prusa3d/SL-CONTROLLER-PCB/rev.06c/SL-controller-06c.pdf

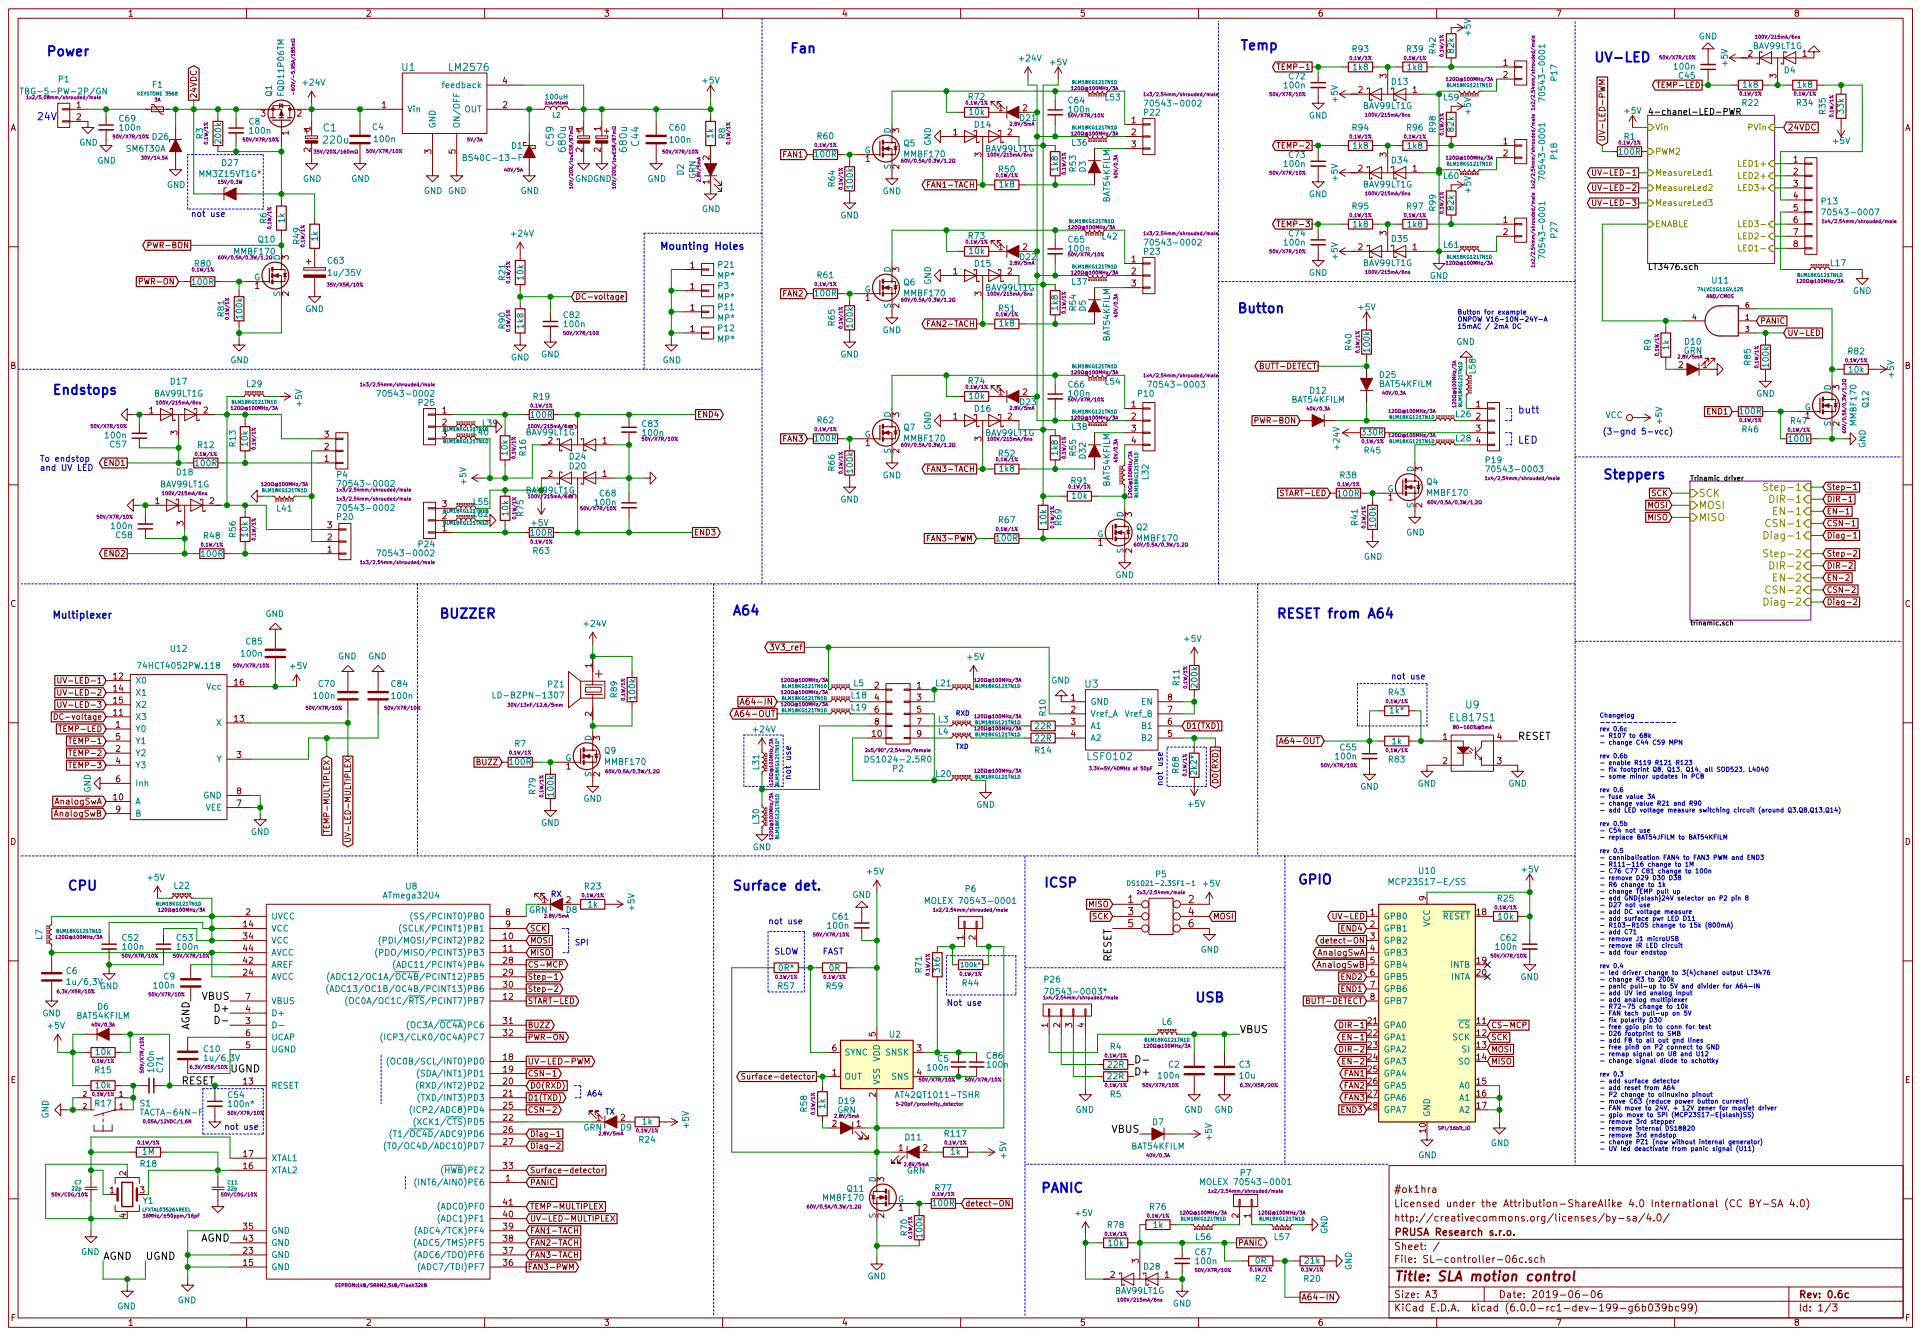
[picture p2: page 1]

TEMP-1 TEMP-2 TEMP-3 GND

Button for example ONPOW V16-10N-24Y-A

Step-1 DIR-1 EN-1 CSN-1 Step-2 DIR-2 EN-2 CSN-2 Diag-2 Diag-1 SCK MOSI MISO

Diag-1
Step-2 DIR-2 EN-2 CSN-2

+5V GND
UV-LED-2 UV-LED-3

Changelog
rev 0.6c
- change C44 C59 MPN
rev 0.6b
- enable R119 R121 R123
- fix footprint Q8, Q13, Q14, all SOD523, L4040
- some minor updates in PCB
rev 0.6
- fuse value 3A
- change value R21 and R90
- add LED voltage measure switching circuit (around Q3,Q8,Q13,Q14)
rev 0.5b
- C54 not use
- replace BAT54JFILM to BAT54KFILM
rev 0.5
- cannibalisation FAN4 to FAN3 PWM and END3
- R111-116 change to 1M
- C76 C77 C81 change to 100n
- remove D29 D30 D38

- R6 change to 1k
- change TEMP pull up
- add GND{slash}24V selector on P2 pin 8
- D27 not use
- add DC voltage measure
- add surface pwr LED D11
- R103-R105 change to 15k (800mA)
- add C71
- remove J1 microUSB
- remove IR LED circuit - add four endstop

rev 0.4
- led driver change to 3(4)chanel output LT3476
- change R3 to 200k
- panic pull-up to 5V and divider for A64-IN
- add UV led analog input - add analog multiplexer
- R72-75 change to 10k
- FAN tach pull-up on 5V
- fix polarity D30
- free gpio pin to conn for test - D26 footprint to SMB
- add FB to all out gnd lines
- free pin8 on P2 connect to GND
- remap signal on U8 and U12

- change signal diode to schottky
rev 0.3
- add surface detector
- add reset from A64
- P2 change to olinuxino pinout - move C63 (reduce power button current)
- FAN move to 24V, + 12V zener for mosfet driver
- gpio move to SPI (MCP23S17-E{slash}SS)
- remove 3rd stepper
- remove internal DS18B20
- remove 3rd endstop
- change PZ1 (now without internal generator)
- UV led deactivate from panic signal (U11)

Licensed under the Attribution-ShareAlike 4.0 International (CC BY-SA 4.0) #ok1hra

Id: 1/3 Title: SLA motion control File: SL-controller-06c.sch Sheet: / PRUSA Research s.r.o. http://creativecommons.org/licenses/by-sa/4.0/

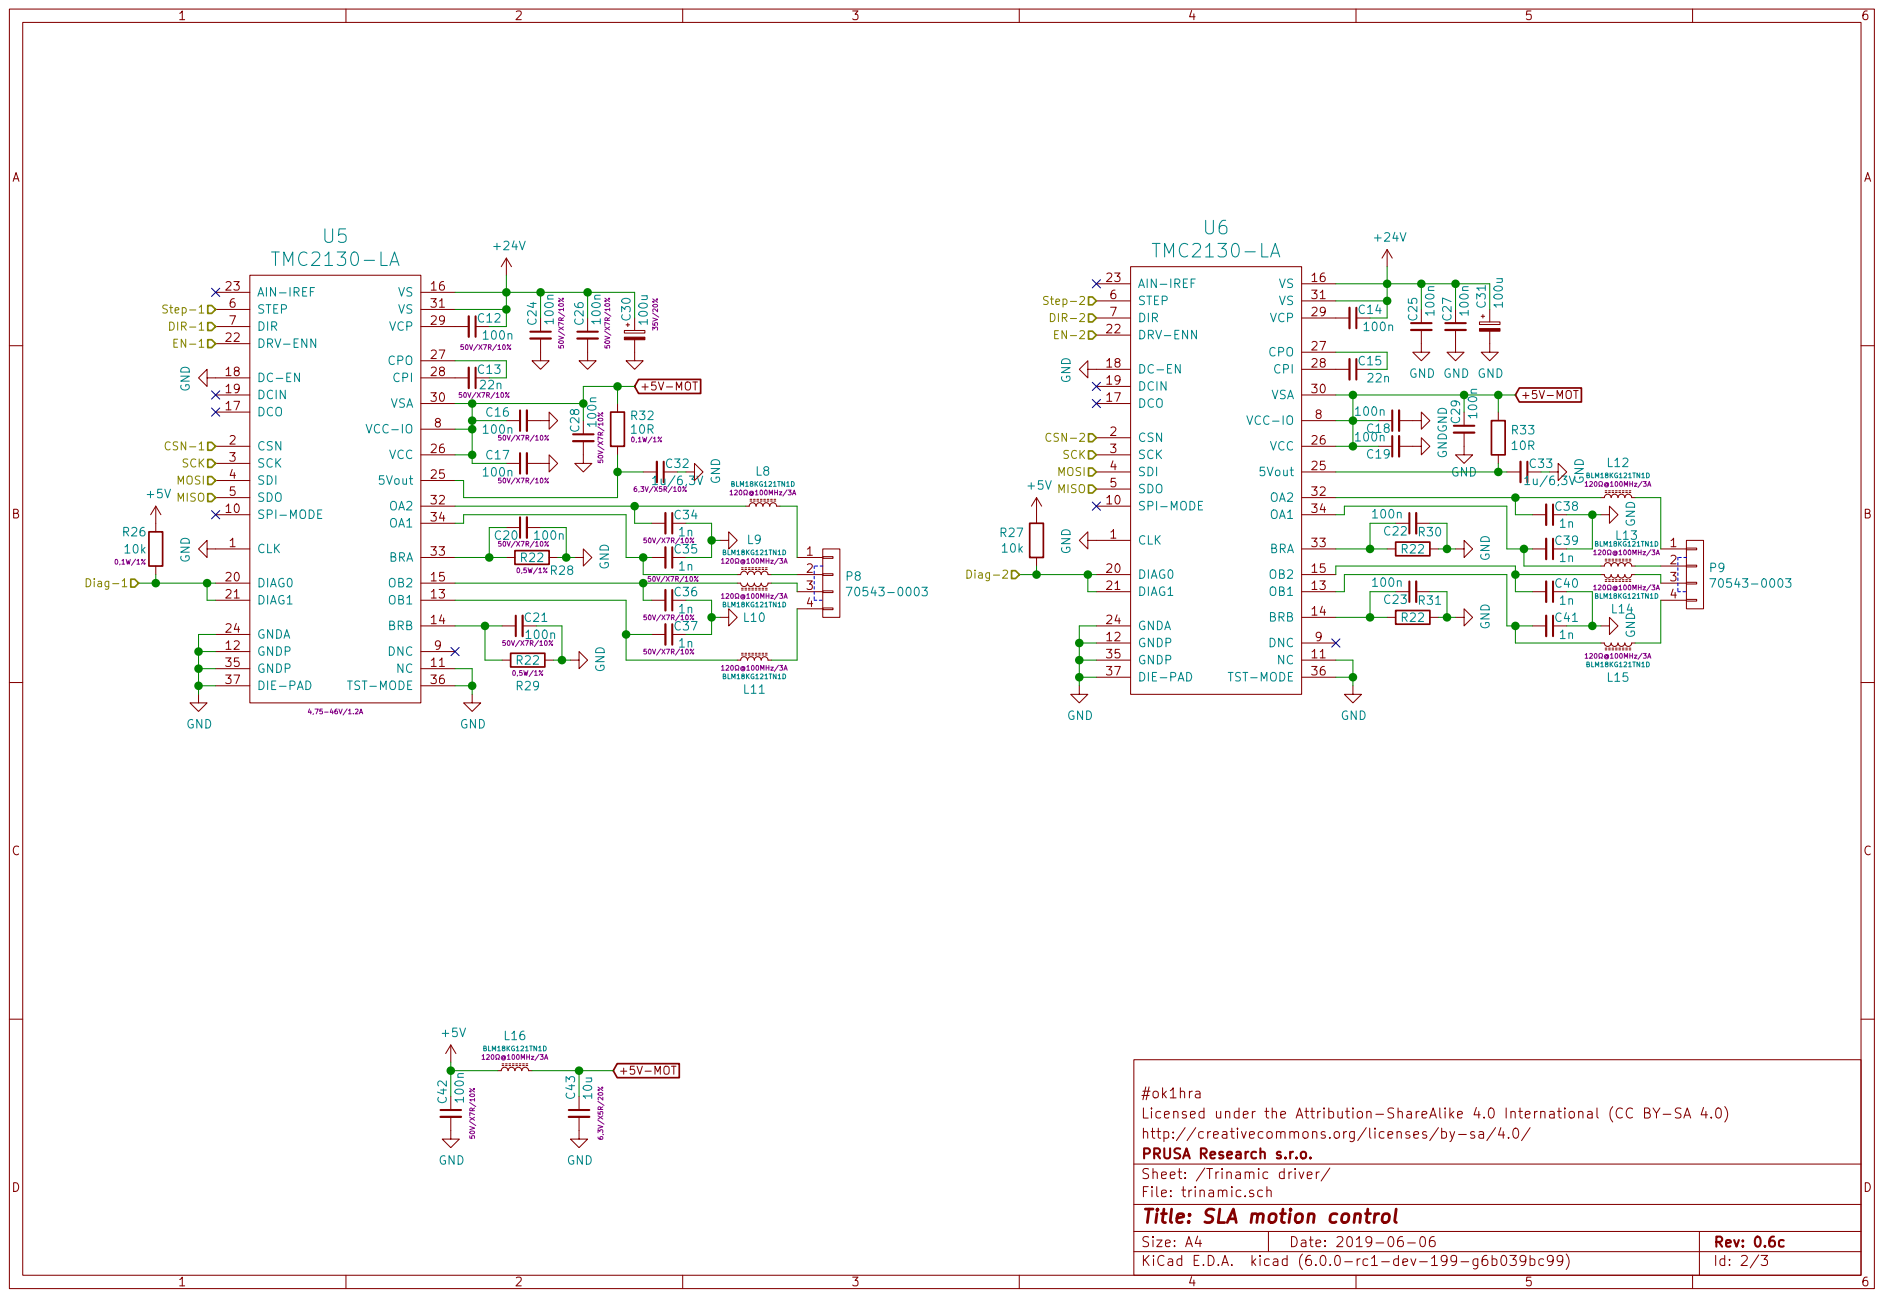
[picture p3: page 2]

TMC2130-LA GND GND
Step-2 DIR-2 EN-2 CSN-2 SCK MOSI MISO

Step-1 DIR-1 EN-1 CSN-1 SCK MOSI MISO

Id: 2/3 Title: SLA motion control File: trinamic.sch Sheet: /Trinamic driver/ PRUSA Research s.r.o. http://creativecommons.org/licenses/by-sa/4.0/

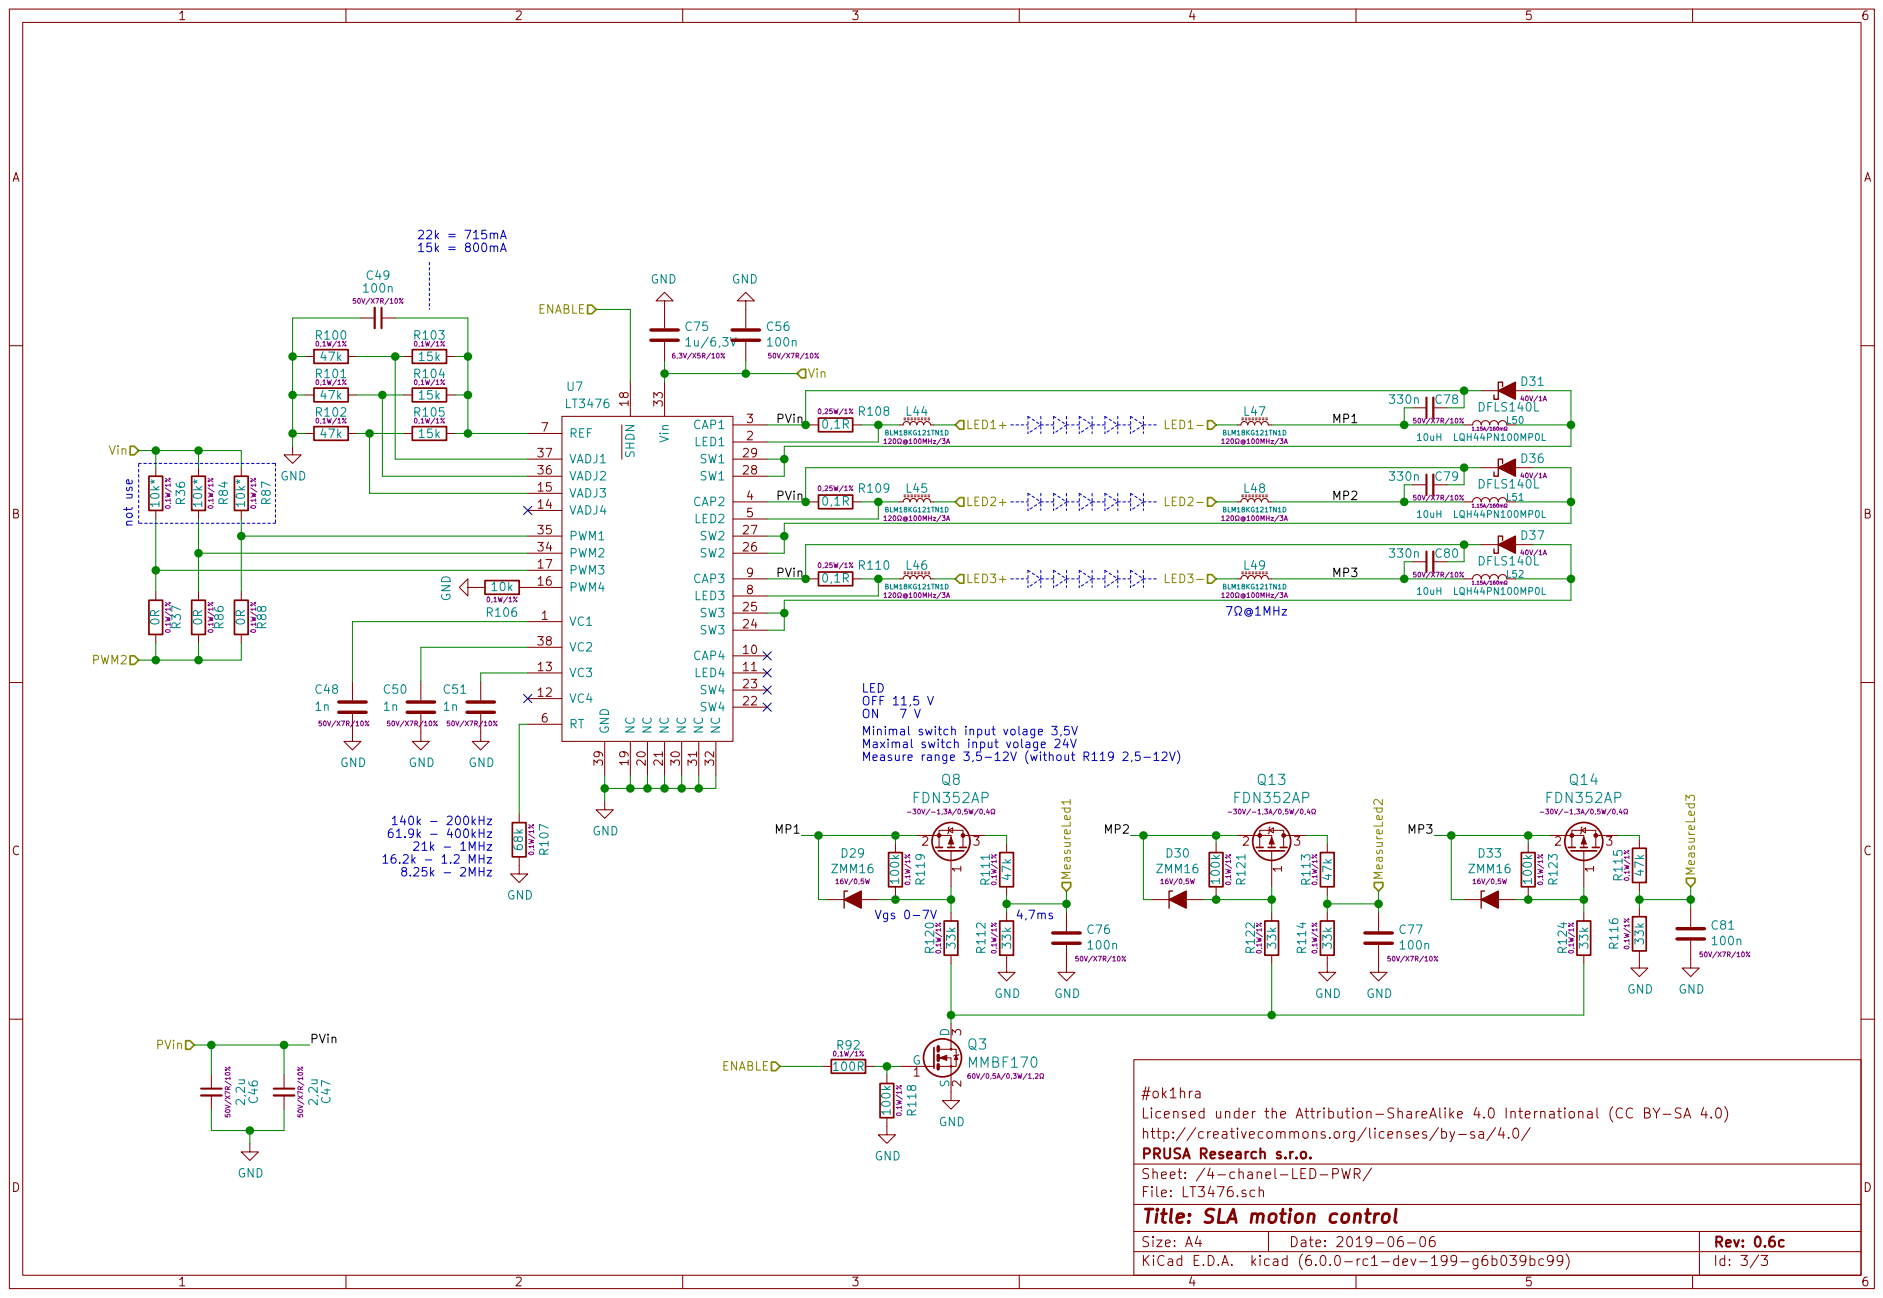
[picture p4: page 3]

Maximal switch input volage 24V

Id: 3/3 Title: SLA motion control File: LT3476.sch Sheet: /4-chanel-LED-PWR/ PRUSA Research s.r.o. http://creativecommons.org/licenses/by-sa/4.0/
