prusa3d/SL-CONTROLLER-PCB/rev.06c/SL-controller-06c.kicad_pcb

## KiCad design rev.06c/SL-controller-06c.kicad_pcb (2019-09-19)

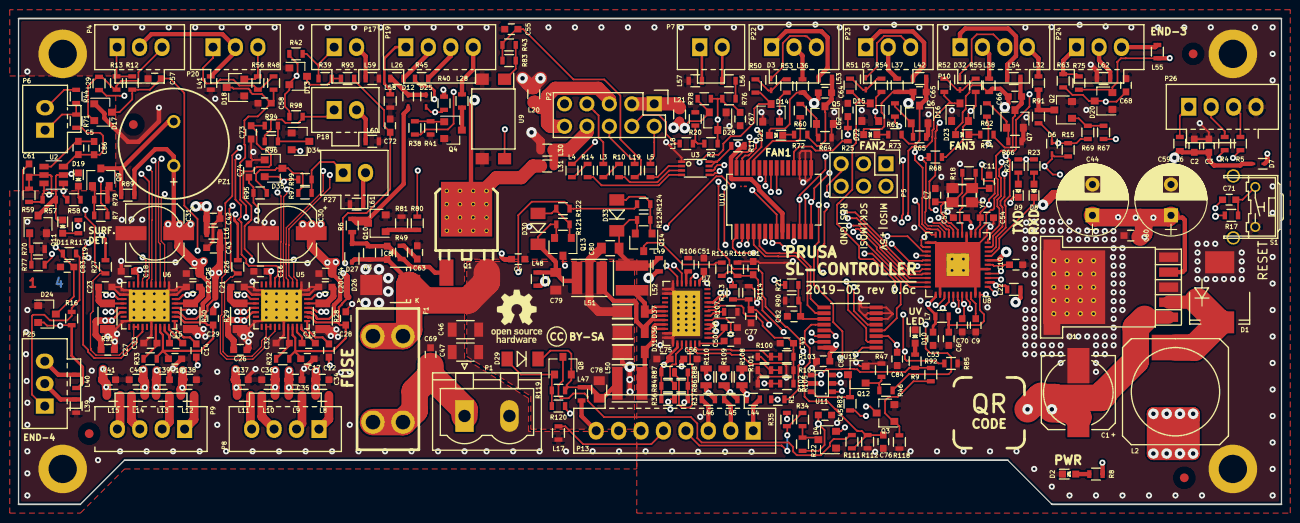
[picture p5: board SL-controller-06c.kicad_pcb from above]

Board: 4 copper layers, 143.0 x 55.0 mm, 354 parts (0 on the bottom side), 230 nets.

Parts:
C1: 220u; c_elec_8x10.5
C2, C4, C5, C8, C9, C12, C14, C16, C17, C18, C19, C20, C21, C22, C23, C24, C25, C26, C27, C28, C29, C42, C45, C49, C52, C53, C55, C56, C57, C58, C60, C61, C62, C64, C65, C66, C67, C68, C69, C70, C71, C72, C73, C74, C76, C77, C81, C82, C83, C84, C85, C86: 100n; C_0603
C3, C43: 10u; C_0603
C6, C10, C32, C33, C75: 1u/6,3V; C_0603
C7, C11: 22p; C_0603
C13, C15: 22n; C_0603
C30, C31: 100u; c_elec_6.3x7.7
C34, C35, C36, C37, C38, C39, C40, C41, C48, C50, C51: 1n; C_0603
C44, C59: 680u; CP_Radial_D8.0mm_P3.50mm
C46, C47: 2,2u; C_1206
C54: 100n*; C_0603
C63: 1u/35V; C_0603
C78, C79, C80: 330n; C_0805
D1: B540C-13-F; SMC_Standard
D2, D8, D9, D10, D11, D19, D21, D22, D23: GRN; LED_0603-ShortSilk
D3, D5, D6, D7, D12, D25, D32: BAT54KFILM; SOD-523-ShortSilk
D4, D13, D14, D15, D16, D17, D18, D20, D24, D28, D34, D35: BAV99LT1G; SOT-23
D26: SM6T30A; SMB_Standard
D27: MM3Z15VT1G*; SOD-323
D29, D30, D33: ZMM16; MiniMELF_Standard
D31, D36, D37: DFLS140L; PowerDI_123
F1: KEYSTONE 3568; Fuse-Keystone-3557-2
L2: 100uH; SELF-WE-PD-XXL
L3, L4, L5, L6, L7, L8, L9, L10, L11, L12, L13, L14, L15, L16, L17, L18, L19, L20, L21, L22, L26, L28, L29, L30, L32, L36, L37, L38, L39, L40, L41, L42, L44, L45, L46, L47, L48, L49, L53, L54, L55, L56, L57, L58, L59, L60, L61, L62: BLM18KG121TN1D; R_0603
L31: BLM18KG121TN1D*; R_0603
L50, L51, L52: 10uH LQH44PN100MP0L; Inductor_Taiyo-Yuden_MD-4040
P1: TBG-5-PW-2P/GN; PhoenixContact_MSTBVA-G_02x5.08mm_Vertical
P2: DS1024-2.5R0; Pin_Header_Straight_2x05
P3, P11, P12, P21: MP*; MountingHole_3.2mm_M3_ISO14580_Pad
P4, P20, P22, P23, P24, P25: 70543-0002; Pin_1x03-XL
P5: DS1021-2.3SF1-1; Pin_Header_Straight_2x03
P6, P7: MOLEX 70543-0001; Pin_1x02-XL
P8, P9, P10, P19: 70543-0003; Pin_1x04-XL
P13: 70543-0007; Pin_1x08-XL
P17, P18, P27: 70543-0001; Pin_1x02-XL
P26: 70543-0003*; Pin_1x04-XL
PZ1: LD-BZPN-1307; Piezo_12.6_5mm
Q1: FQD11P06TM; DPAK-heatsink
Q2, Q3, Q4, Q5, Q6, Q7, Q9, Q10, Q11, Q12: MMBF170; SOT-23
Q8, Q13, Q14: FDN352AP; SOT-23
Q15: QRcode; QR-code-8x8mm
R1, R7, R12, R19, R38, R46, R48, R60, R61, R62, R63, R67, R77, R80, R92: 100R; R_0603
R2, R37, R59, R86, R88: 0R; R_0603
R3, R11: 200k; R_0603
R4, R5, R10, R14: 22R; R_0603
R6, R8, R9, R23, R24, R49, R58, R76, R83, R117: 1k; R_0603
R13, R15, R16, R17, R21, R25, R26, R27, R56, R69, R72, R73, R74, R75, R78, R82, R91, R106: 10k; R_0603
R18: 1M; R_0603
R20: 21k; R_0603
R22, R34, R39, R50, R51, R52, R53, R54, R55, R90, R93, R94, R95, R96, R97: 1k8; R_0603
R28, R29, R30, R31: R22; R_1206
R32, R33: 10R; R_0603
R35, R112, R114, R116, R120, R122, R124: 33k; R_0603
R36, R84, R87: 10k*; R_0603
R40, R41, R47, R64, R65, R66, R70, R79, R81, R85, R89, R118, R119, R121, R123: 100k; R_0603
R42, R98, R99: 82k; R_0603
R43: 1k*; R_0603
R44: 100k*; R_0603
R45: 330R; R_0603
R57: 0R*; R_0603
R68: 2k2*; R_0603
R71: 3k6; R_0603
R100, R101, R102, R111, R113, R115: 47k; R_0603
R103, R104, R105: 15k; R_0603
R107: 68k; R_0603
R108, R109, R110: 0,1R; R_0805
S1: TACTA-64N-F; TACT-90
U1: LM2576; TO-263-5-heatsink
U2: AT42QT1011-TSHR; SOT-23-6
U3: LSF0102
U5, U6: TMC2130-LA; QFN-36-1EP_5x6mm_Pitch0.5mm-GNDpad-0.3mm
U7: LT3476; QFN-38-1EP_5x7mm_Pitch0.5mm
U8: ATmega32U4; QFN-44-1EP_7x7mm_Pitch0.5mm
U9: EL817S1; Optocoupler_SMD_LTV-817S
U10: MCP23S17-E/SS; SSOP-28_5.3x10.2mm_Pitch0.65mm
U11: 74LVC1G11GV.125; SOT457
U12: 74HCT4052PW.118; TSSOP-16_4.4x5mm_Pitch0.65mm
Y1: LFXTAL035264REEL; Crystal-3.2x2.5mm

Connections:
3V3_ref: L5.2, U3.2
24VDC: C8.1, C46.1, C47.1, C78.2, C79.2, C80.2, D26.1, D27.1, D31.1, D36.1, D37.1, F1.1, Q1.3, R3.1, R108.2, R109.2, R110.2, U7.3, U7.4, U7.9
+5V: C42.1, C44.1, C56.1, C59.1, C60.1, C61.2, C62.1, C75.1, C85.2, D4.2, D6.1, D7.1, D13.2, D14.2, D15.2, D16.2, D20.2, D24.2, D28.2, D34.2, D35.2, L2.2, L16.1, L21.2, L22.1, L29.1, L40.1, L55.1, P5.2, R8.1, R11.1, R15.2, R16.2, R17.2, R23.1, R24.1, R25.1, R26.1, R27.1, R35.1, R36.1, R40.2, R42.1, R53.2, R54.2, R55.2, R59.2, R68.2, R69.1, R75.1, R78.2, R82.1, R84.1, R87.1, R91.1, R98.1, R99.1, R117.2, U1.4, U2.5, U7.33, U10.9, U11.5, U12.16
+5V-MOT: C16.1, C17.1, C18.1, C19.1, C28.1, C29.1, C43.1, L16.2, R32.1, R33.1, U5.8, U5.26, U5.30, U6.8, U6.26, U6.30
+24V: C1.1, C4.2, C12.1, C14.1, C24.1, C25.1, C26.1, C27.1, C30.1, C31.1, C64.2, C65.2, C66.2, D21.2, D22.2, D23.2, L31.2, L36.2, L37.2, L38.2, PZ1.1, Q1.2, R21.1, R45.1, R89.1, U1.1, U5.16, U5.31, U6.16, U6.31
/4-chanel-LED-PWR/MP1: C78.1, D29.1, L47.2, L50.1, Q8.2, R119.1
/4-chanel-LED-PWR/MP2: C79.1, D30.1, L48.2, L51.1, Q13.2, R121.1
/4-chanel-LED-PWR/MP3: C80.1, D33.1, L49.2, L52.1, Q14.2, R123.1
/D+: R5.2, U8.4
/D-: R4.1, U8.3
/ENABLE: R9.2, R92.2, U7.18, U11.4
/LED1+: L44.2, P13.1
/LED1-_1: L47.1, P13.8
/LED2+: L45.2, P13.2
/LED2-_1: L48.1, P13.7
/LED3+: L46.2, P13.3
/LED3-: L49.1, P13.6
/PWM2: R1.2, R37.1, R86.1, R88.1
/RESET: C54.1, C71.1, D6.2, P5.5, R15.1, U8.13, U9.4
/VBUS: C2.2, C3.2, D7.2, L6.2, U8.7
A64-IN: L18.2, R2.1, R20.2
A64-OUT: C55.1, L19.2, R43.1, R83.1
AnalogSwA: U10.4, U12.10
AnalogSwB: U10.5, U12.9
BUTT-DETECT: D25.2, R40.1, U10.8
BUZZ: R7.1, U8.31
CS-MCP: U8.28, U10.11
CSN-1: U5.2, U8.19
CSN-2: U6.2, U8.25
D0(RXD): R68.1, U3.5, U8.20
D1(TXD): U3.6, U8.21
DC-voltage: C82.1, R21.2, R90.1, U12.11
DIR-1: U5.7, U10.21
DIR-2: U6.7, U10.23
Diag-1: R26.2, U5.20, U5.21, U8.26
Diag-2: R27.2, U6.20, U6.21, U8.27
EN-1: U5.22, U10.22
EN-2: U6.22, U10.24
END1: C57.1, D17.3, R12.2, R46.1, U10.7
END2: C58.1, D18.3, R48.2, U10.6
END3: C68.2, D20.3, R63.2, U10.28
END4: C83.1, D24.3, R19.1, U10.2
FAN1: R60.1, U10.25
FAN1-TACH: D14.3, R50.1, U8.39
FAN2: R61.1, U10.26
FAN2-TACH: D15.3, R51.1, U8.38
FAN3: R62.1, U10.27
FAN3-PWM: R67.1, U8.36
FAN3-TACH: D16.3, R52.1, U8.37
GND: C1.2, C2.1, C3.1, C4.1, C6.1, C7.2, C9.1, C10.1, C11.2, C16.2, C17.2, C18.2, C19.2, C20.2, C21.2, C22.2, C23.2, C24.2, C25.2, C26.2, C27.2, C28.2, C29.2, C30.2, C31.2, C32.1, C33.1, C34.1, C35.1, C36.1, C37.1, C38.1, C39.1, C40.1, C41.1, C42.2, C43.2, C44.2, C45.2, C46.2, C47.2, C48.1, C49.2, C50.1, C51.1, C52.2, C53.2, C54.2, C55.2, C56.2, C57.2, C58.2, C59.2, C60.2, C61.1, C62.2, C63.2, C67.2, C68.1, C69.2, C70.1, C72.2, C73.2, C74.2, C75.2, C76.1, C77.1, C81.1, C82.2, C83.2, C84.1, C85.1, D1.2, D2.1, D4.1, D10.1, D13.1, D14.1, D15.1, D16.1, D17.1, D18.1, D20.1, D24.1, D26.2, D28.1, D34.1, D35.1, L17.2, L20.2, L30.1, L39.1, L41.2, L57.2, L58.2, L59.2, L60.2, L61.2, L62.1, P1.2, P3.1, P5.6, P11.1, P12.1, P21.1, P26.4, Q2.2, Q3.2, Q4.2, Q5.2, Q6.2, Q7.2, Q9.2, Q10.2, Q11.2, Q12.2, R20.1, R28.1, R29.1, R30.1, R31.1, R41.2, R47.1, R64.2, R65.2, R66.2, R70.2, R79.2, R81.2, R85.2, R90.2, R100.2, R101.2, R102.2, R106.1, R107.1, R112.2, R114.2, R116.2, R118.2, S1.2, U1.3, U1.5, U3.1, U5.1, U5.11, U5.12, U5.18, U5.24, U5.35, U5.36, U5.37, U6.1, U6.11, U6.12, U6.18, U6.24, U6.35, U6.36, U6.37, U7.19, U7.20, U7.21, U7.30, U7.31, U7.32, U7.39, U8.5, U8.15, U8.23, U8.35, U8.43, U9.2, U9.3, U10.10, U10.15, U10.16, U10.17, U11.2, U12.6, U12.7, U12.8, Y1.2, Y1.4
MISO: P5.1, U5.5, U6.5, U8.11, U10.14
MOSI: P5.4, U5.4, U6.4, U8.10, U10.13
unnamed: C5.1, C86.1, R71.2, U2.3
unnamed: C5.2, C86.2, U2.4
unnamed: C6.2, L7.1, U8.24, U8.44
unnamed: C7.1, R18.2, U8.17, Y1.1
unnamed: C8.2, D27.2, Q1.1, R3.2, R6.1, R49.1
unnamed: C9.2, U8.42
unnamed: C10.2, U8.6
unnamed: C11.1, R18.1, U8.16, Y1.3
unnamed: C12.2, U5.29
unnamed: C13.1, U5.27
unnamed: C13.2, U5.28
unnamed: C14.2, U6.29
unnamed: C15.1, U6.27
unnamed: C15.2, U6.28
unnamed: C20.1, R28.2, U5.33
unnamed: C21.1, R29.2, U5.14
unnamed: C22.1, R30.2, U6.33
unnamed: C23.1, R31.2, U6.14
unnamed: C32.2, R32.2, U5.25
unnamed: C33.2, R33.2, U6.25
unnamed: C34.2, L8.1, U5.32
unnamed: C35.2, L9.1, U5.34
unnamed: C36.2, L10.1, U5.15
unnamed: C37.2, L11.1, U5.13
unnamed: C38.2, L12.1, U6.32
unnamed: C39.2, L13.1, U6.34
unnamed: C40.2, L14.1, U6.15
unnamed: C41.2, L15.1, U6.13
unnamed: C48.2, U7.1
unnamed: C49.1, R103.1, R104.1, R105.1, U7.7
unnamed: C50.2, U7.38
unnamed: C51.2, U7.13
unnamed: C52.1, C53.1, L7.2, L22.2, U8.2, U8.14, U8.34
unnamed: C63.1, R49.2
unnamed: C64.1, L53.2, Q5.3, R72.1
unnamed: C65.1, L42.2, Q6.3, R73.1
unnamed: C66.1, L54.2, Q7.3, R74.1
unnamed: C69.1, F1.2, P1.1
unnamed: C71.2, R17.1, S1.1
unnamed: D1.1, L2.1, U1.2
unnamed: D2.2, R8.2
unnamed: D3.1, P22.3
unnamed: D3.2, R50.2, R53.1
unnamed: D4.3, R22.2, R34.1
unnamed: D5.1, P23.3
unnamed: D5.2, R51.2, R54.1
unnamed: D8.1, U8.8
unnamed: D8.2, R23.2
unnamed: D9.1, U8.22
unnamed: D9.2, R24.2
unnamed: D10.2, R9.1
unnamed: D11.1, D19.1, P6.2, Q11.3, R44.2, R57.1, U2.2
unnamed: D11.2, R117.1
unnamed: D12.1, D25.1, L26.2
unnamed: D13.3, R39.1, R93.2
unnamed: D17.2, D18.2, L29.2, P4.3, P20.3, R13.1, R56.1
unnamed: D19.2, R58.1
unnamed: D21.1, R72.2
unnamed: D22.1, R73.2
unnamed: D23.1, R74.2
unnamed: D29.2, Q8.1, R119.2, R120.1
unnamed: D30.2, Q13.1, R121.2, R122.1
unnamed: D31.2, L50.2, U7.28, U7.29
unnamed: D32.1, P10.3
unnamed: D32.2, R52.2, R55.1
unnamed: D33.2, Q14.1, R123.2, R124.1
unnamed: D34.3, R94.2, R96.1
unnamed: D35.3, R95.2, R97.1
unnamed: D36.2, L51.2, U7.26, U7.27
unnamed: D37.2, L52.2, U7.24, U7.25
unnamed: L3.1, P2.7
unnamed: L3.2, R10.2
unnamed: L4.1, P2.9
unnamed: L4.2, R14.2
unnamed: L5.1, P2.2
unnamed: L6.1, P26.1
unnamed: L8.2, P8.1
unnamed: L9.2, P8.2
unnamed: L10.2, P8.3
unnamed: L11.2, P8.4
unnamed: L12.2, P9.1
unnamed: L13.2, P9.2
unnamed: L14.2, P9.3
unnamed: L15.2, P9.4
unnamed: L17.1, P13.5
unnamed: L18.1, P2.4
unnamed: L19.1, P2.6
unnamed: L20.1, P2.5, P2.10
unnamed: L21.1, P2.1, P2.3
unnamed: L26.1, P19.2
unnamed: L28.1, P19.4
unnamed: L28.2, Q4.3
unnamed: L30.2, L31.1, P2.8
unnamed: L32.1, Q2.3, R91.2
unnamed: L32.2, P10.4
unnamed: L36.1, P22.2
unnamed: L37.1, P23.2
unnamed: L38.1, P10.2
unnamed: L39.2, P25.2
unnamed: L40.2, P25.3
unnamed: L41.1, P4.2, P20.2
unnamed: L42.1, P23.1
unnamed: L44.1, R108.1, U7.2
unnamed: L45.1, R109.1, U7.5
unnamed: L46.1, R110.1, U7.8
unnamed: L53.1, P22.1
unnamed: L54.1, P10.1
unnamed: L55.2, P24.3
unnamed: L56.1, R76.2
unnamed: L56.2, P7.2
unnamed: L57.1, P7.1
unnamed: L58.1, P19.1
unnamed: L59.1, P17.2
unnamed: L60.1, P18.2
unnamed: L61.1, P27.2
unnamed: L62.2, P24.2
unnamed: P4.1, R12.1, R13.2
unnamed: P6.1, R44.1, R71.1
unnamed: P13.4, R34.2, R35.2
unnamed: P17.1, R39.2, R42.2
unnamed: P18.1, R96.2, R98.2
unnamed: P19.3, R45.2
unnamed: P20.1, R48.1, R56.2
unnamed: P24.1, R63.1, R75.2
unnamed: P25.1, R16.1, R19.2
unnamed: P26.2, R4.2
unnamed: P26.3, R5.1
unnamed: P27.1, R97.2, R99.2
unnamed: PZ1.2, Q9.3, R89.2
unnamed: Q2.1, R67.2, R69.2
unnamed: Q3.1, R92.1, R118.1
unnamed: Q3.3, R120.2, R122.2, R124.2
unnamed: Q4.1, R38.2, R41.1
unnamed: Q5.1, R60.2, R64.1
unnamed: Q6.1, R61.2, R65.1
unnamed: Q7.1, R62.2, R66.1
unnamed: Q8.3, R111.2
unnamed: Q9.1, R7.2, R79.1
unnamed: Q10.1, R80.2, R81.1
unnamed: Q11.1, R70.1, R77.1
unnamed: Q12.1, R46.2, R47.2
unnamed: Q12.3, R82.2, U11.6
unnamed: Q13.3, R113.2
unnamed: Q14.3, R115.2
unnamed: R10.1, U3.3
unnamed: R11.2, U3.7, U3.8
unnamed: R14.1, U3.4
unnamed: R25.2, U10.18
unnamed: R36.2, R37.2, U7.17
unnamed: R43.2, R83.2, U9.1
unnamed: R57.2, R59.1, U2.6
unnamed: R84.2, R86.2, U7.34
unnamed: R87.2, R88.2, U7.35
unnamed: R100.1, R103.2, U7.37
unnamed: R101.1, R104.2, U7.36
unnamed: R102.1, R105.2, U7.15
unnamed: R106.2, U7.16
unnamed: R107.2, U7.6
PANIC: C67.1, D28.3, R2.2, R76.1, R78.1, U8.1, U11.1
PWR-BON: D12.2, Q10.3, R6.2
PWR-ON: R80.1, U8.32
SCK: P5.3, U5.3, U6.3, U8.9, U10.12
START-LED: R38.1, U8.12
Step-1: U5.6, U8.29
Step-2: U6.6, U8.30
Surface-detector: R58.2, U2.1, U8.33
TEMP-1: C72.1, R93.1, U12.5
TEMP-2: C73.1, R94.1, U12.2
TEMP-3: C74.1, R95.1, U12.4
TEMP-LED: C45.1, R22.1, U12.1
TEMP-MULTIPLEX: C84.2, U8.41, U12.3
UV-LED: R85.1, U10.1, U11.3
UV-LED-1: C76.2, R111.1, R112.1, U12.12
UV-LED-2: C77.2, R113.1, R114.1, U12.14
UV-LED-3: C81.2, R115.1, R116.1, U12.15
UV-LED-MULTIPLEX: C70.2, U8.40, U12.13
UV-LED-PWM: R1.1, U8.18
detect-ON: R77.2, U10.3
